nayan-kasireddi/Cricket-Swing-Analyzer/hardware/pcb/V1cricket_swing_carrier.kicad_pcb

## KiCad design hardware/pcb/V1cricket_swing_carrier.kicad_pcb (2026-10-23)

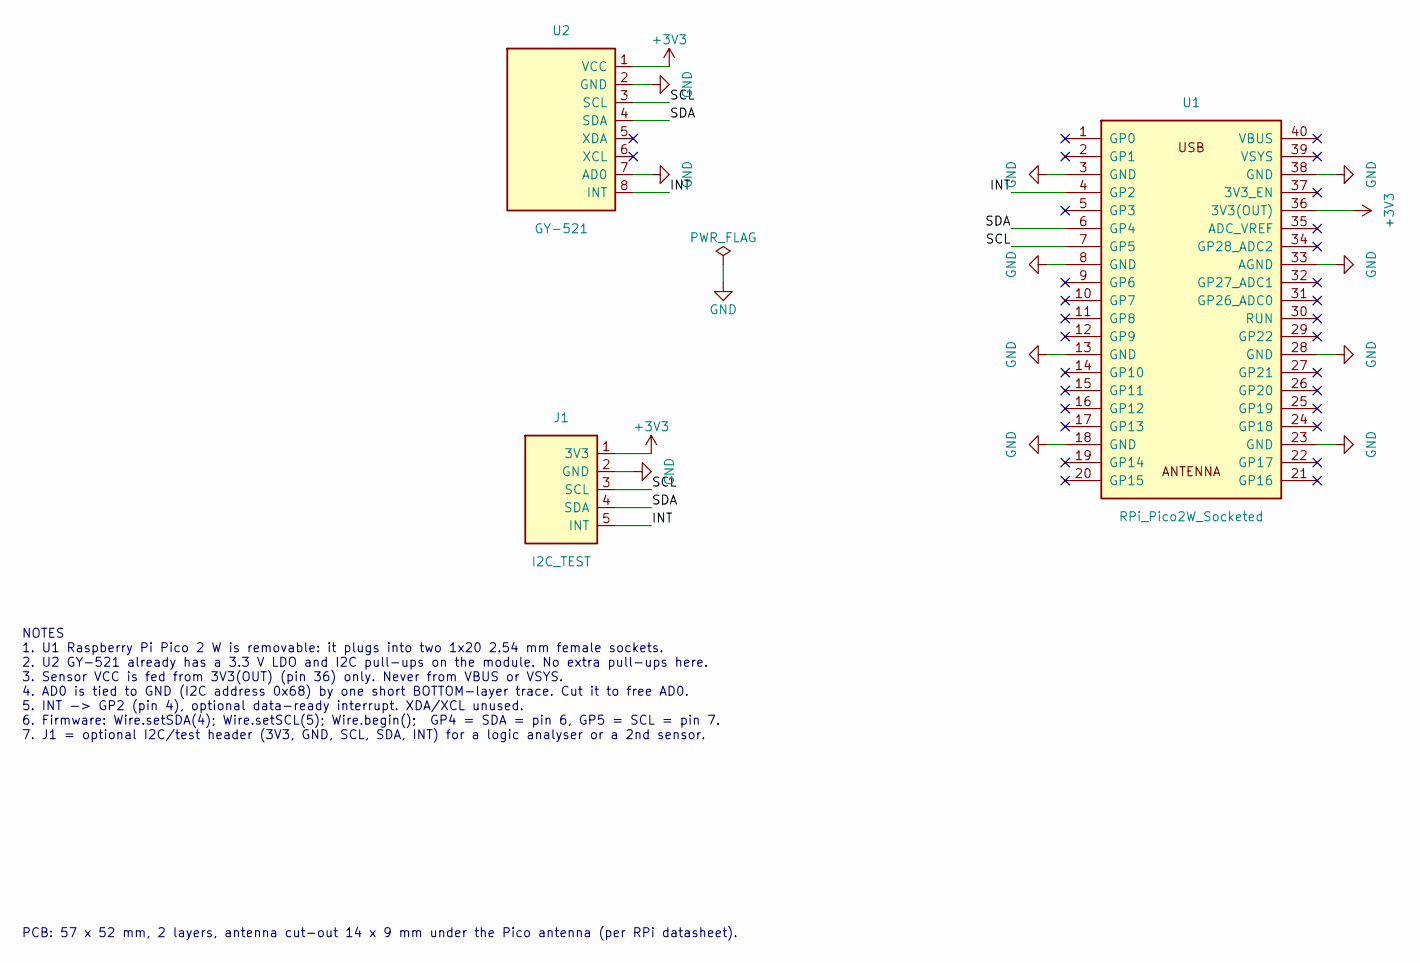
[picture p1: schematic V1cricket_swing_carrier.kicad_sch, Cricket Swing Analyzer - Pico 2 W + GY-521 carrier]

Parts:
J1: I2C_TEST; PinHeader_1x05_P2.54mm_Vertical
U1: RPi_Pico2W_Socketed
U2: GY-521; GY-521_HW-123_1x08

Connections:
+3V3: J1.1 (3V3), U1.36 (3V3(OUT)), U2.1 (VCC)
/INT: J1.5 (INT), U1.4 (GP2), U2.8 (INT)
/SCL: J1.3 (SCL), U1.7 (GP5), U2.3 (SCL)
/SDA: J1.4 (SDA), U1.6 (GP4), U2.4 (SDA)
GND: J1.2 (GND), U1.3 (GND), U1.8 (GND), U1.13 (GND), U1.18 (GND), U1.23 (GND), U1.28 (GND), U1.33 (AGND), U1.38 (GND), U2.2 (GND), U2.7 (AD0)

Notes on the sheet:
NOTES 1. U1 Raspberry Pi Pico 2 W is removable: it plugs into two 1x20 2.54 mm female sockets. 2. U2 GY-521 already has a 3.3 V LDO and I2C pull-ups on the module. No extra pull-ups here. 3. Sensor VCC is fed from 3V3(OUT) (pin 36) only. Never from VBUS or VSYS. 4. AD0 is tied to GND (I2C address 0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
PCB: 57 x 52 mm, 2 layers, antenna cut-out 14 x 9 mm under the Pico antenna (per RPi datasheet).

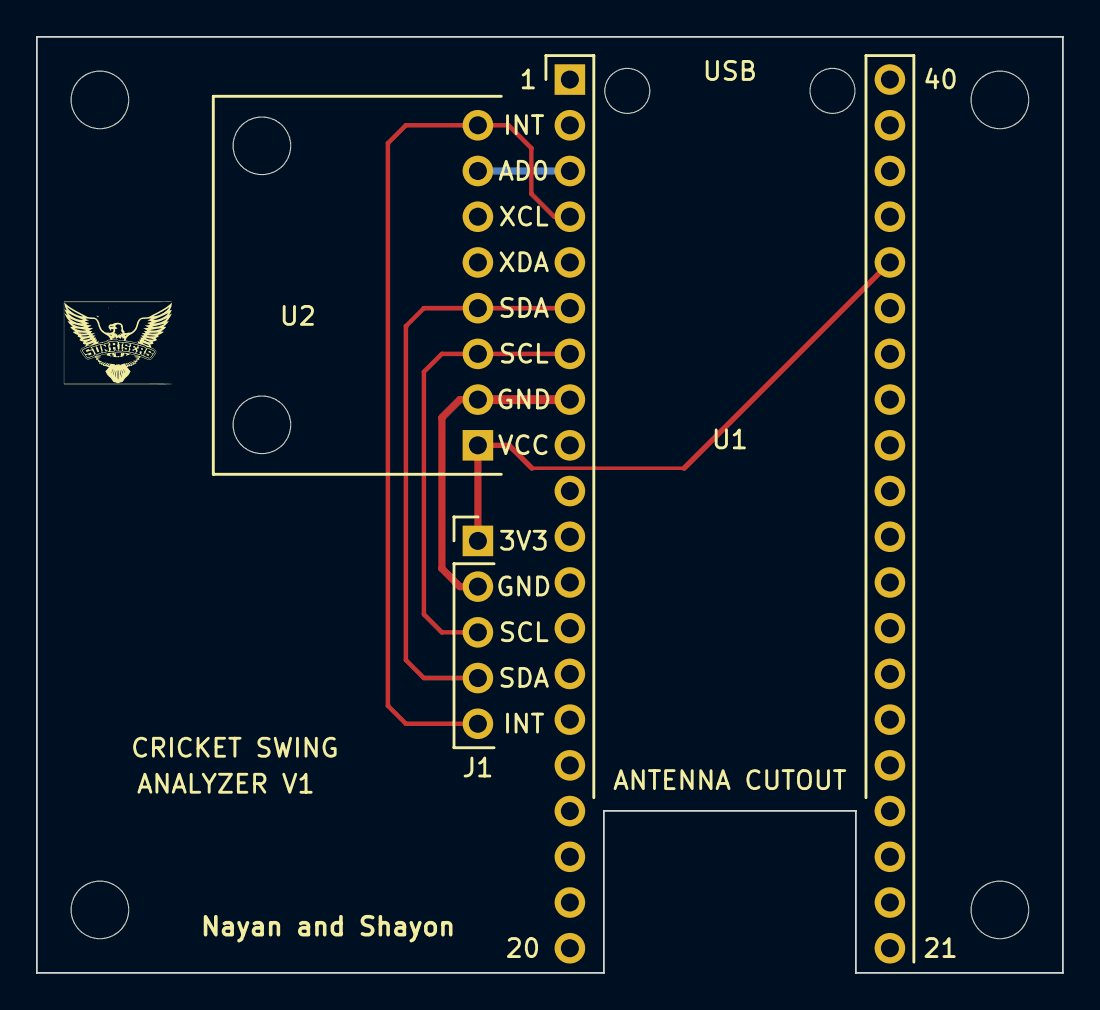
[picture p2: board V1cricket_swing_carrier.kicad_pcb from above]

Board: 2 copper layers, 57.0 x 52.0 mm, 7 parts (0 on the bottom side), 5 nets.

Other parts of the board:
H1, H2, H3, H4: MountingHole_3.2mm_M3
