nayan-kasireddi/Cricket-Swing-Analyzer/python/core.py

"""
Core cricket swing analysis algorithms.
"""

def acceleration_magnitude(df):
    """Calculate total acceleration magnitude."""
    pass


def detect_swing(df, threshold):
    """Detect swings from sensor data."""
    pass
