nayan-kasireddi/Cricket-Swing-Analyzer/(commit log)

2026-10-01 Add ingest, analyze, live viewer, and tests
    [multi_swing.csv, normal_swing.csv, slow_swing.csv, stationary.csv]
2026-10-15 Add Raspberry Pi Pico 2 W blink test
2026-10-15 Add files via upload
    First hardware test of the Raspberry Pi Pico 2 W using Arduino IDE, verifying board functionality with a basic LED blink program.
2026-10-18 Add Pico 2 W LED blink test
2026-10-21 Add Pico 2 W MPU6050 100Hz sensor firmware
2026-10-21 Upgrade MPU6050 firmware to 500Hz polling
2026-10-21 Update ingest for 500 Hz Pico format; add Streamlit dashboard
    [multi_swing.csv, normal_swing.csv, slow_swing.csv, stationary.csv]
2026-10-23 Skip stale lines at the start of live recordings
    [dashboard.py]
2026-10-23 Redesign dashboard: scoreboard layout, live swing log, plain-language labels
    [dashboard.py, live.py, ui.py]
2026-10-23 Document 500 Hz workflow and fix Python recording edge cases
    [dashboard.py, ingest.py, live.py, swings.py]
2026-10-23 Rename cricket_swing_carrier.kicad_pcb to V1cricket_swing_carrier.kicad_pcb
    version 1 PCB
    [V1cricket_swing_carrier.kicad_pcb]
2026-10-23 Rename cricket_swing_carrier.kicad_sch to V1cricket_swing_carrier.kicad_sch
    version one
    [V1cricket_swing_carrier.kicad_sch]
2026-10-23 Update README with dashboard screenshots and current project status
2026-10-23 Redesign cricket dashboard and support automatic sensor discovery
    [dashboard.py, live.py, ui.py]
2026-10-23 Add standalone Netlify cricket swing website
    [multi_swing.csv, normal_swing.csv, slow_swing.csv, stationary.csv]
2026-10-23 Fix dashboard CSS: fill in placeholders lost in merge
    [ui.py]
